tgd1975/automatic_christmas_bell/weihnachtsglocke_Schaltplan.png

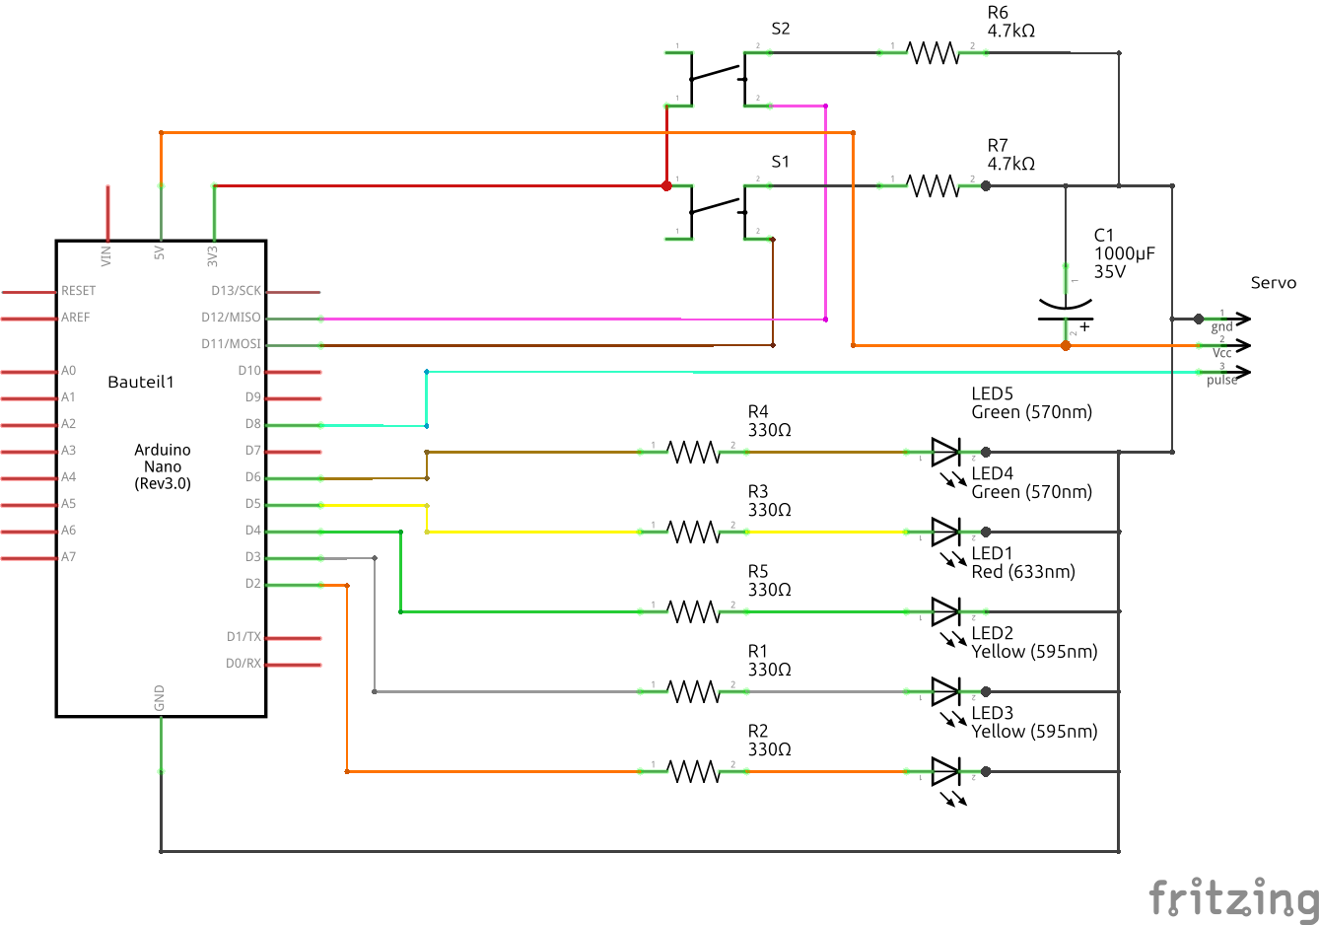
weihnachtsglocke_Schaltplan.png
