tgd1975/automatic_christmas_bell/TODO.md

# Todos

Was nur du selbst tun kannst: Konto, Zahlung, Freigabe, Hardware in der Hand. Was ein Chat selbst kann, gehört nicht
hierher. Form (Stilvorlage dieser Datei):

- offen: `- [ ] TD-<n> - **Was:** Befehl oder Link – warum. *(Chat)*`
- erledigt: `- [x] TD-<n> - **Was:** was daraus wurde (Commit). [2026-11-01]` – ein verworfenes sagt es

Jeder Punkt hat Kästchen und Kennung, offen wie erledigt. Die Kennung gilt nur in dieser Datei, wird hochgezählt und nie
wieder vergeben, auch für erledigte nicht; wer eine Zeile einträgt, nimmt die nächste und zählt sie hier hoch. Vor
jeder Änderung die Datei frisch lesen und nur eigene Zeilen ändern (außer Kennung und Form). Erledigt: sofort abhaken,
Datum ans Ende, nach „## Erledigt“ am Ende verschieben, neueste zuerst – der Chat, der es erfährt, nicht nur der, der
die Zeile schrieb. Keine Zeile wird gelöscht. Überschriften gruppieren offene Todos; ist unter einer keines mehr offen,
gehen Überschrift und Text, bis das nächste dazukommt.

Nächste Kennung: TD-9

## Für dich

- [ ] TD-8 - **THT-Platinen aufbauen** (tht und esp32tht, geliefert 2026-11-11): Schritt für Schritt nach
  [docs/aufbau.md](docs/aufbau.md), zum Drucken `build/aufbau/aufbau.pdf`; die Messwerte aus Schritt 8 (Messen) in den
  Chat. Warum: erst dann gehen TD-1 und TD-2 auf der Platine, und eine laufende Platine kommt mit
  `edakit release publish --built` in die Freigabe. *(automatic-christmas-bell, 2026-11-11)*
- [ ] TD-1 - **ESP32-Firmware auf einem T-Display ausprobieren:**
  `cd variants/esp32/firmware && pio run -e tdisplay -t upload`, dann Hotspot `Glocke-XXXX` (WLAN-Analyse-App: Kanal
  1–13, WPA2), Einrichtung, <http://glocke.local> und Display prüfen, Aufdruck „T-DISPLAY V1.1“ ansehen; Tasten, LEDs
  und Servo erst auf der Platine. Warum: bisher nur übersetzt und am Rechner getestet. *(automatic-christmas-bell-41)*
- [ ] TD-2 - **Nano-Firmware ausprobieren:** `pio run -e nano -t upload` im Repo; nach dem Läuten fährt das Servo in
  die Ruhestellung und ist 1 s später abgeschaltet. Warum: bisher nur übersetzt. *(automatic-christmas-bell-41)*

## Erledigt

- [x] TD-4 - **Platinen bestellt:** die zwei THT-Varianten (tht, esp32tht) unbestückt, je 5 Stück, mit pytrees Baum in
  einer JLCPCB-Bestellung; Teile bei LCSC, mit ihr zusammengelegt (dazu 2 gekerbte 1×40-Buchsenleisten C2916940 als
  Extra), DHL Express. Die Glocken-Platinen gingen ohne Prüfprotokoll in den Warenkorb – edakit konnte unbestückte
  JLCPCB-Platinen erst ab 0.4.17. Hauptplatine, smd und esp32 nicht bestellt. [2026-11-02]
- [x] TD-7 - **edakit-Plugin auf 0.4.14 gehoben:** user- und Projekt-Eintrag 0.4.14, Bridge-Erweiterung 1.6.0 =
  Server 1.6.0 (edakit doctor); der Klon über SSH ging nicht (kein GitHub-Schlüssel) – git leitet
  `git@github.com:tgd1975/` jetzt auf HTTPS um. [2026-11-01]
- [x] TD-6 - **Vier Warnungen DOCS.derived akzeptiert** (R-1, R-3, R-4, R-12, Grund D-39) auf main, smd und esp32 –
  alle drei RELEASED (D-41, 1fa3ba8). [2026-11-01]
- [x] TD-5 - **Blanke Stellen im GND-Kupfer schließen:** ja – main, smd und esp32 mit Stitching-Vias gefüllt, M-5 neu
  (D-41, 67f0b44). [2026-11-01]
- [x] TD-3 - **T-Display vermessen, bevor die ESP32-Platine bestellt wird:** verworfen – D-37: CE-Zeichen vorhanden,
  kein Vermessen; das Footprint bleibt bei LILYGOs Zeichnungen (D-13) (bdc3678). [2026-11-01]
