tgd1975/automatic_christmas_bell/(list of files, drawings)

Other design files:
docs/old/weihnachtsglocke.fzz
weihnachtsglocke.fzz
