tgd1975/automatic_christmas_bell/(commit log)

2026-10-25 Add xmas-bell project files: Arduino sketch and Fritzing schematic
    Generated by Mistral Vibe.
    [weihnachtsglocke.fzz]
2026-10-25 Add comprehensive project documentation
    - Hardware component analysis from Fritzing schematic
    - Software architecture documentation
    - Functional description of countdown and bell mechanism
    - Pin mappings and configuration options
    - Troubleshooting guide and extension ideas
    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
2026-10-25 Add .gitignore for Arduino and Fritzing files
    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
2026-10-25 Update project description with Christkind tradition context
    - Added traditional Austrian/German Christmas context
    - Emphasized mechanical bell vs electronic sound
    - Added detailed use case description
    - Included mechanical assembly suggestions
    - Added tips for staging the Christmas surprise
    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
2026-10-25 Update docs: servo arm hangs down, bell below, intended position in bookshelf
    - README.md: added position details
    - PROJEKT.md: added mechanical arrangement section
    - Intended position: bookshelf with downward-hanging servo arm
    - Bell hangs below, children focused on tree anyway
    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
2026-10-25 Platine mit edakit: Graph, Teile-DB, Simulation, Abzeichnungen
    Hardware-Graph aus weihnachtsglocke.fzz (17 Bauteile, 15 Netze), Teile-DB
    mit LCSC-Nummern, Simulation mit USB-Versorgung, Servo-Last und Tastern,
    Platinenplan 85 x 56 mm für JLCPCB, Entscheidungen E-1 bis E-6.
    edakit check: 0 Fehler; edakit sim: 1112 Prüfungen bestanden.
2026-10-25 Board files in English for the edakit example; EasyEDA project christmas-bell
    The board is the public example of easyEDAAutomation, so graph, parts
    entries, simulation, sign-offs and decisions (docs/decisions.md, D-1..D-6)
    are in English. Buttons switch 5 V instead of 3.3 V (D-4).
2026-10-25 Restructure project: move files to src/firmware/ and docs/old/
    - src/firmware/buttons.ino (was: buttons.ino)
    - docs/old/weihnachtsglocke.* (was: weihnachtsglocke.*)
    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
    [weihnachtsglocke.fzz]
2026-10-25 Board through the gate: fixed resistor positions, LEDs with + on one side, D-7 open
    Generated in EasyEDA project christmas-bell: schematic = graph, PCB routed
    (3 vias, DRC 0), silkscreen clean. Gate: all stages pass except L-9 – the
    Nano footprint's 0.9 mm holes are too small for 0.64 mm header tails (D-7).
2026-10-25 hardware/README.md: the board as edakit example, with plan, routing and silkscreen images
2026-10-25 Apply code review improvements to buttons.ino
    Critical fixes:
    - Fix digitalWrite(-1) by initializing currentledpin to ledRed
    - Add button debouncing (50ms delay) to prevent false triggers
    - Replace blocking delay(10) with non-blocking timer in finishCycle()
    Structural improvements:
    - Introduce explicit state machine with SystemState enum
    - Add timeExpired() helper for safe millis() overflow handling
    - Refactor countdownVisualization to use LED array/loop
    - Replace magic numbers with SERVO_MIN/MAX/REST_ANGLE constants
    - Reduce baud rate from 500000 to 115200 for better compatibility
    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
    [buttons.ino]
2026-10-25 Add build system files: platformio.ini, Makefile, and update README
    - platformio.ini: Configuration for Arduino Uno/Nano with avr platform
    - Makefile: Compile/upload/monitor targets for arduino-cli
    - README.md: Added detailed flashing instructions for all 3 methods
    (Arduino IDE, PlatformIO, Arduino CLI) + troubleshooting table
    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
2026-10-25 Add silkscreen image to README.md
    - Updated README.md to include hardware/img/silkscreen_top.png
    - Added Bestückungsplan section with image reference
    - Updated project structure tree in README
    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
2026-10-25 Board revision 1.0, printed bottom left with the title
2026-10-25 Base load for power banks (D-8), silkscreen artwork and labels
    - R8 ∥ R9 (2 x 100 Ω 2512) keep USB power banks on: 123-135 mA idle,
    checked against a 100 mA minimum in every scenario; graph v0.2
    - hardware/art/make_art.py draws bell, greeting, small bell, chevrons,
    stars and snowflakes; edakit.toml places them, plus START/RESET and the
    servo pin labels (positions follow the current layout, preview only)
2026-10-25 Firmware: builds again, buttons debounce, bell pauses at the end points
    From the M-1 review and a check against the original sketch:
    - bellactive was no longer declared; cyclestarttime and
    nextbellupdatetime are unsigned long (millis arithmetic)
    - debouncing compared the raw reading with the debounced state, so a
    change was never accepted and both buttons were dead; now the raw
    reading of the previous loop is kept (Arduino Debounce example)
    - the bell used timeExpired() with nextbellupdatetime += 400 ms: a time
    in the future counted as expired at once, the 400 ms pause at the end
    points was lost; back to the original next-update logic, overflow-safe
    - currentledpin starts at -1 aga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
    [buttons.ino]
2026-10-25 Board label in German; D-9 LED row stays, D-10 no power switch
2026-10-25 Layout round: base load placed, silkscreen artwork and labels, German board label
    Gate 20261025-211616: every stage passes except L-9 (D-7); DRC 0, 2 vias.
2026-10-25 Silkscreen with printed capital heights; pour clear of the mounting holes
2026-10-25 M-5 signed (gate run 20261025-213920): printed capitals >= 1.0 mm, pour clear of the holes
2026-10-25 D-7: Nano footprint with 1.1 mm holes; gate without findings
    U1 uses the footprint of C9900187880 (1.1 mm holes, same pad numbering,
    turned by 270° in the plan); its symbol labels pins 14/15 swapped (PB4/PB3)
    - documented, connections by pin number. Text fixes and datasheet entries
    of J1 and C1 from the M-1 review. Gate 20261025-215346: no check fails,
    M-1 and M-5 open for the new state.
2026-10-25 M-1 and M-5 signed for the Nano footprint swap (D-7)
2026-10-26 Board variants SMD, THT, ESP32: graphs, parts, simulation, drawn schematics
    Three variants of the carrier board, each its own edakit project under
    variants/ and its own board in the EasyEDA project christmas-bell
    (D-11 to D-15). Offline: 0 errors, every design hint handled, every
    simulation scenario passes. The T-Display device script creates the
    module's symbol and footprint in the EasyEDA project library.
2026-10-26 Variants through EasyEDA: boards, schematics, PCBs routed, silkscreen
    Boards smd, tht and esp32 in the EasyEDA project christmas-bell; template
    and board schematics equal to the graphs, PCBs placed from the plans,
    routed with Freerouting (DRC clean apart from EasyEDA's "Import Changes"
    note), silkscreen without print on pads. The T-Display device is a
    stand-in (C18722937) whose project copies of symbol and footprint are
    rebuilt (D-13); keep-outs around the Nano's corner holes.
2026-10-26 hardware/README.md: link to the board variants
2026-10-26 M-1 signed for the variants smd, tht and esp32
    Independent electrical reviews (agent electrical-reviewer) of the three
    circuits, OK without critical or important findings. esp32: stale texts
    in the C17408 entry and the R8/R9 notes corrected, M-1 confirmed for the
    new state; D-13 and variants/README.md carry the review notes (USB-C CC,
    module orientation, firmware requirements, hand soldering).
2026-10-26 Variants: layout round after the M-5 reviews
    esp32: anode links R->LED as fixed top tracks (no vias in the LED row,
    LED4's label above its LED again), U1 footprint texts 1.5 mm and the USB
    box inside the board, "5V" mark at U1.1, order-number placeholder under
    the module. smd/esp32: keep-outs under the chevrons. tht: 12 mil
    clearance for hand soldering, tracks preferably on the bottom. smd/tht:
    order-number placeholder under the Nano.
2026-10-26 M-5 signed for the variants smd, tht and esp32
    Independent layout reviews (agent pcb-reviewer) on the manufacturing
    files of gate runs 20261026-123018/-123036/-123051: OK for all three
    layouts. variants/README.md: status per variant and what is left – the
    one "Import Changes" click per PCB, then gate runs with the other tabs
    closed and a comparison of the Gerber files with the reviewed runs.
2026-10-26 edakit: board, schematic and pin locks in files of their own
    edakit (148d525) reads edakit.toml as the table of contents now. Moved once with
    edakit's scripts/split_config.py, for the main board and the variants smd, tht
    and esp32:
    - hardware/boards/<board>.toml: outline, holes, tooling holes, placement,
    routing, pours, silkscreen and artwork – word for word, comments included;
    the layout hash covers this file now instead of edakit.toml.
    - hardware/schematic.toml: blocks, notes and pin table of the schematic.
    - [checks] pin_locks into the graph as "checks" – part of the circuit hash.
    Every value read back unchanged; on a copy, edakit check, hints and pcb plan
    gave the same output wi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
2026-10-26 variants/README.md: status after the config split – M-6 open
    The offline gate with edakit 148d525 counts M-1 and M-5 of all three variants
    and leaves M-6 (regulatory review) open next to L-3. M-6 needs the owner's
    purpose decision first.
2026-10-26 Purpose private for all four boards (D-16), radio data of the T-Display
    The owner's purpose decision for the regulatory review M-6: main, smd, tht and esp32
    are built for the owner's own use. The purpose is part of the circuit hash, so M-1
    has to be confirmed again on all four boards. The T-Display's parts entry gets the
    ESP32's radio data from its datasheet v5.3; LILYGO publishes no EU declaration of
    conformity for the module.
2026-10-26 ESP32: radio sources of the T-Display corrected, radio stays off in the firmware
    From the M-6 review: LILYGO publishes a test lab's CE attestation (not an EU
    declaration of conformity), an FCC grant and a Japanese MIC certificate for the
    T-Display V1.1; the MIC certificate gives the antenna gain (-4.32 dBi) and Wi-Fi
    channel 14. The parts entry now cites them. D-13 gets the firmware requirement
    that Wi-Fi and Bluetooth stay off, and the purpose notes and the README say: USB
    power only, no cell at the module's battery input.
2026-10-26 M-1 confirmed and M-6 signed on all four boards (purpose private, D-16)
    M-1: the change adds only the purpose and, on esp32, the T-Display's compliance
    data – checks, simulation and hints unchanged (agent electrical-reviewer).
    M-6 (agent regulatory-reviewer): main, smd and tht OK – no transmitter, 5 V USB,
    no battery, no mains; esp32 OK after one round – the firmware keeps Wi-Fi and
    Bluetooth off (D-13), USB power without a cell. Offline gates count M-1, M-5 and
    M-6 on all four; the variants still need L-3 (Import Changes in EasyEDA).
2026-10-26 Nano firmware: the servo is detached at rest
    From the M-6 note (D-16), with the owner's OK: after the bell phase, and when a
    button interrupts it, the servo moves to its rest position and is detached one
    second later; it is attached again when the next bell phase starts. A jam at rest
    no longer loads the Nano's 5V until the bell is unplugged (D-3). Built with
    PlatformIO (env nano).
    [buttons.ino]
2026-10-26 ESP32 firmware: countdown, display and a web page with a setup hotspot (D-17)
    The owner's wish: a simple web page on the ESP32 board – status, time to ding,
    start, stop, pause, set the timer – and a hotspot on the first start to set the
    home network. variants/esp32/firmware is a PlatformIO project:
    - lib/BellTimer: the countdown without hardware (timer = time to ding, pause,
    LED pattern), 12 host tests (pio test -e native);
    - src/main.cpp: buttons, LEDs, servo on LEDC (detached at rest), display;
    reset held 3 s = Wi-Fi on/off, 10 s = forget the home network;
    - src/net.cpp: setup hotspot with captive portal (WPA2, password made once and
    shown on the display), station in the home net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
    [main.cpp, net.cpp, net.h]
2026-10-26 ESP32: M-1 and M-6 renewed for Wi-Fi (D-17)
    M-1 (agent electrical-reviewer): with i_core_a 0.27 A the module's 1N5819 carries
    0.28 W in the bell phase and 0.48 W stalled for at most 5.8 s (rating 550 mW), the
    AP2112K stays within 600 mA, a USB source of at least 1 A is right; the firmware
    keeps the requirements of D-13. M-6 (agent regulatory-reviewer): station and setup
    hotspot only on channels 1-13 (country DE, 802.11d off), about 16 dBm e.i.r.p.,
    no Bluetooth. Offline gate 20261026-172213 counts M-1, M-5 and M-6. The README
    says to erase the module's flash before it leaves the house and to use an analog
    servo; M-4 checks the hotspot and the module's marking.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
2026-10-26 D-18: the reviewers' suggestions filed as edakit proposals #21-#27
    With the owner's OK: radio power and antenna gain (#21), bands within the EU or
    the radio use stated (#22), modules and microcontrollers state their radio (#23),
    EMVG § 6 and REACH Art. 33 for own use and gifts (#24), a lower bound of a
    module's current (#25), dissipation of a module's on-board LDO (#26), ESP32
    country with 802.11d off (#27). Sealed with edakit proposal seal.
2026-10-28 variants/README.md: status with edakit a8b6011 – hashes kept, P-5 open
    The offline gates with edakit a8b6011 (runs 20261028-085249) keep every hash and
    count M-1, M-5 and M-6. New is warning P-5 on the Nano boards: the Nano is bought
    separately and its parts entry names no supplier. It waits for the owner: shop
    and order code, or the warning accepted with the Nanos at hand (TODO.md).
2026-10-28 D-19: the Nanos are at hand – P-5 accepted; M-5 lapsed with edakit f6dd9f7
    Owner's decision: edakit's warning P-5 (supplier per part, since a8b6011) is
    accepted for U1 (C9900187880) on main, smd and tht – the Nanos are at hand. The
    acceptance names the part, so it lapses when U1 changes.
    edakit f6dd9f7 puts the artwork SVGs into the layout hash, so all four layout
    hashes are new and M-5 no longer counts. The SVGs are unchanged since 7667817,
    older than every M-5 review: the owner confirms M-5 for the new hashes after the
    EasyEDA gates (TODO.md), whose pcb dump may change the footprint geometry too.
2026-10-28 D-20: M-5 bound to the manufacturing files of the reviewed runs (scope fab)
    Since edakit f6dd9f7 the artwork SVGs count in the layout hash, so M-5 lapsed on all four
    boards although the boards did not change. M-5 now has edakit's default scope fab and is
    bound to the fab hash of the gate run its reviewer checked; the EasyEDA gate counts it when
    it exports the same files. No confirmation by the owner is needed.
2026-10-28 Footprint geometry beside the board files, versioned (edakit step 1.8)
    edakit d63a81a reads the geometry from hardware/boards/<b>.geometry.json, so CI and a fresh
    clone can compute the layout hash, and make clean no longer deletes it. The four files were
    moved from build/edakit/ as edakit check suggested. The layout hashes change once (main
    037fdb66, smd cebf13a6, tht 4c4bf230, esp32 7f428bbc). Circuit and fab hashes stay the same,
    so M-1, M-5 (scope fab, D-20) and M-6 keep counting.
2026-10-28 make clean: delete only .pio – build/ holds edakit's gate runs
    Neither arduino-cli nor PlatformIO builds into build/; there lie edakit's artifacts, among them
    the reviewed and the released gate runs of the main board.
2026-10-28 Regulatory review: support, not legal advice (owner's instruction)
    The owner asked that wherever regulatory matters come up it says so: no legal advice, no
    claim to correctness, nothing legally guaranteed. Added to D-16, the radio bullet of D-13,
    both READMEs and the M-6 text of the four sign-off files, which the gate protocol prints.
    The sign-off files are in no hash, so M-6 keeps counting.
2026-10-29 D-18: edakit accepted all seven proposals (main bf7450a) – G-24, G-25, P-11, two features
    For a private board G-25 and P-11 are notes (owner's rule: edakit reports what the firmware has to keep but does
    not block on it), so the gate decisions stay. The entries that clear the notes and the keys of #25/#26 change the
    circuit hash; they come with each board's next circuit change.
2026-10-31 Release of all four boards (2026-10-30): gates with EasyEDA RELEASED, D-21
    After Import Changes on smd, tht and esp32, the gates of edakit b36a6d0 failed only L-17 (the silk files of an
    older silk apply). silk apply ran again; the manufacturing files are the reviewed runs' (D-20), so M-5 counts.
    The footprints' own print and main's copper-free spot are accepted warnings (D-21, owner).
    The runs were made on 8a25612 plus this commit's sign-off changes. Runs: main 20261030-232729 (supersedes
    20261025-220549), smd 20261030-232631, tht 20261030-232650, esp32 20261030-232707 – they stay in build/.
2026-10-31 Manufacturing files are build output: not archived, published with the order (make publish, D-22)
    The owner rejected the archived gate runs (build artifacts, not repository content). What holds a release is
    the sign-offs' hashes; the gate re-exports identical files while the PCB is untouched, and JLCPCB keeps ordered
    files.
    make publish (tools/publish_release.py): edakit release current per board, edakit release verify on the order
    files, build/publish/<tag>/ with SHA256SUMS and notes, gh release create --prerelease, tag = the date. Guards:
    clean tree, HEAD on origin/main. make publish-draft tests it as a draft (done today: 21 files, deleted again);
    make publish-built TAG=<tag> drops the pr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
2026-10-31 D-22: the owner wants no-archive and publish as edakit's default – handed to edakit as a prompt
2026-10-31 Variant ESP32 THT: the T-Display board with through-hole parts, no assembly (D-23)
    Graph, parts, simulation and drawn schematic of a fifth board esp32tht:
    the circuit of the variant ESP32 with the THT parts of the variant THT,
    100 ohm THT series resistors (C57438) and 5 mm yellow-green LEDs
    (XL-504SYGD, C2895551). purpose.radio states channels 1-13. In the
    form of edakit main 5196c6f; check 0 errors, sim 1436 passes.
2026-10-31 ESP32 THT: red and yellow dimmed to the yellow-green (330 ohm), order and layout hand-over (D-23)
    Owner's decision after M-1: R1, R2, R5 330 ohm (C58608) so that the
    50-200 mcd yellow-green LEDs and the 400-900 mcd red and yellow ones look
    alike. From the M-1 review: U1 names its supplier (the stand-in left the
    LCSC cart), the two 1x12 female headers as [[extra]], the layout
    hand-over in the graph, U1's least current and LDO thermal data, LED
    colour from edakit's list, R8/R9 notes. M-6 signed for e4a24024 (now
    superseded, renewal follows). Board file and seed geometry for the
    layout; variants/README.md with the fifth board.
2026-10-31 ESP32 THT: the servo header at its place of every board, not at the edge
2026-10-31 ESP32 THT: layout round – placed, routed (0 vias), silkscreen
    The T-Display 3.5 mm nearer the front than on esp32 so that tht's
    staggered THT resistors fit; R8/R9 standing between the module and C1,
    their names inside their bodies. Geometry from pcb dump (its hole sizes
    are 10x too small – edakit bug, reported; dump again after the fix).
2026-10-31 ESP32 THT: M-1 and M-6 signed for state bcb27b87 (agents, D-23)
2026-10-31 ESP32 THT: layout notes of M-5 – LED marks, label off the edge, two tracks to the bottom, looks guard
2026-10-31 ESP32 THT: geometry dumped again with the hole unit fixed, LED_G1 fixed on the bottom – 0 vias
    The dump ran with edakit's fix/dump-hole-unit (c831353: main 6c3cb90 plus the one fix), the holes are now the
    footprints' (1.1 mm sockets, 0.91 mm LEDs). Routing with the M-5 notes left one via on LED_G1, which changed to the
    top for its last 6 mm; its route is now a fixed wire on the bottom. Routed: 16 nets, 0 vias, top 0.27 m, DRC 0;
    silkscreen 19/19 designators, 0 on mask openings.
2026-10-31 ESP32 THT: M-5 signed on gate run 20261031-154618, the buttons' print accepted as D-21 (1)
    M-5 by the agent pcb-reviewer on fab hash b768d2f5… – no block or important finding; notes: S1/S2's 1.3 mm holes do
    not hold the snap-in legs (press them flat while soldering), a stale via drill file in the working export (deleted,
    not part of the run). Owner's decision 2026-10-31: D-21 (1) holds for esp32tht too – accepted, bound to S1/S2 =
    C110153. Recorded in D-23.
2026-10-31 ESP32 THT: released – gate run 20261031-160323, status and order note in variants/README.md
    The second gate run on the same manufacturing files (fab b768d2f5…) is RELEASED with M-1, M-5 and M-6 signed and the
    buttons' print accepted (D-21 (1)). `edakit release verify` accepts the current release of all five boards, so
    `make publish` takes esp32tht along. esp32tht has no order-number placeholder – noted for the order.
2026-10-31 All boards in edakit's current file form – edakit convert on main, smd, tht and esp32 (D-24)
    edakit 8bdb933 no longer reads the form before its restructuring. Graph, parts entries and sign-off files converted;
    M-1/M-6 rehashed, releases unchanged, check/sim/docs pass on all five boards.
2026-10-31 Decisions D-25 to D-29: the bell on edakit 868e942 – migrate first, LIM.p on esp32 accepted, order form keys, wires, publish with edakit
2026-10-31 Graph as TOML on all five boards (edakit graph convert, L.9) – graph.json is the generated file now
    edakit graph json against the former graph.json: only conventions.pin_reference differs (and key order).
    M-1/M-6 rehashed, releases unchanged. The mentions of graph.json name the generated file (hardware/README.md,
    docs/decisions.md, the esp32 firmware's comment, also its stale checks.pin_locks → locks.pins).
2026-10-31 Guard rails: pre-commit hook with edakit check/sim/graph json --check per board, project settings with the plugin; esp32 LIM.p accepted (D-26)
    tools/edakit finds edakit ($EDAKIT, PATH, the installed plugin) for the hook and the Makefile.
    core.hooksPath = .githooks (once per clone).
2026-10-31 Scripts registered (plan 4.2): kunst in all five configurations, tdisplay (symbol) in esp32 – both stamped, the art unchanged; make publish runs edakit release publish (D-29)
    tools/publish_release.py goes; [release] archive = "none" and publish = { variants, decisions } in the main
    configuration.
2026-10-31 T-Display's footprint as data on esp32 and esp32tht (D-30, plan 3.6) – the symbol stays tdisplay_device.py's
2026-10-31 Nano pin print from edakit's A000005 in main, smd, tht (D-31, W.5)
2026-10-31 D-27 changed: no order number on any board – the placeholder leaves smd, tht and esp32
    JLCPCB's form no longer offers an order number (edakit-c9, ordering step 0, 2026-10-31). Owner's decision: mark
    "remove" on all five boards and nothing instead. The JLCJLCJLCJLC silk text comes off the three board files; the
    ordering note in variants/README.md says "Remove Mark". EasyEDA and the gate follow in the D-25 round.
2026-10-31 Requirements file (plan 4.1, D-32): shared, Nano and ESP32 files, all accepted; IMPLEMENTIERUNG.md to docs/old/, README and AGENTS to the built state
2026-10-31 Servo start as transient run for R-9 (D-33); the circuit items waiting since D-18/D-23 (D-34); hook: its own variable, so that EDAKIT from the environment reaches tools/edakit
2026-10-31 Schematic drawings with wires on all five boards (D-28), main's drawn for the first time
2026-10-31 Order form, cost, sockets, firmware contract and quoted values as keys (steps 8 and 9, D-35)
2026-10-31 Stock snapshots of all five boards (edakit stock, 2026-11-01)
2026-10-31 D-36: the ESP32 boards' radio in Austria – the CE-marked module is the radio equipment (owner, M-6 finding E1)
2026-10-31 M-1 and M-6 signed anew on all five boards (agents electrical-reviewer, regulatory-reviewer; edakit bc44fa7) – M-6 on the electrical hash, D-36 for the ESP32 radio
2026-10-31 esp32, esp32tht: geometry dumped again – U1's pads with shape, size and hole for SYNC.footprint (passes)
2026-10-31 M-5 signed on the gate runs of 2026-11-01 (agent pcb-reviewer): placeholder off, order.json new, nothing else changed
2026-10-31 All five boards released on edakit bc44fa7 (runs 20261101-0055..0058) – status in variants/README.md
2026-11-01 D-37: the T-Display bears the CE mark and has the standard row spacing – no measuring; its open item and print wait for the next circuit change
2026-11-01 docs: why the bell's requirements restate edakit's checks, and proposals A–F for edakit (requirements-review.md, gap 10)
2026-11-01 docs: edakit-gaps 10 – the count as in requirements-review.md
2026-11-01 docs: requirements are the pipeline's inputs (owner, 2026-11-01) – requirements-review.md and gap 10 rewritten: 17 of 20 derived, the README's inputs missing, proposals A–G
2026-11-01 docs: requirements-review.md – proposal C in two cases: forward (the maker states) and reverse (infer from the circuit, filter, marked as inferred, owner confirms)
2026-11-01 docs: requirements-review.md – C compact, F as today plus a source word (owner: don't overengineer the process)
2026-11-01 docs: requirements-proposal.toml – the bell's requirements as the pipeline's inputs, for review (not read by edakit; parsed by edakit req in a throwaway project: 9 needs, 13 requirements)
2026-11-01 D-38: the requirements proposal reviewed by the owner – level fits, LED order and jam confirmed, one requirement per assembly (SMD, THT) for both modules
2026-11-01 D-39: the requirements proposal accepted as a whole; it replaces D-32's files after the order; proposals A–G to edakit
2026-11-01 docs/organisation.md: what each part of the repository is, who keeps it, how it changes, and what a review of the documentation may change – as edakit's docs/organisation.md; AGENTS.md and the README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
2026-11-01 D-39: edakit #98 accepted – DOCS.derived built in #96
2026-11-01 TODO.md: was nur der Besitzer tun kann, aus der projektübergreifenden Liste ~/Dokumente/Projekte/TODO.md hierher (die gibt es nicht mehr); die drei Bestellzeilen zu einer mit dem Skill cart, das Plug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
2026-11-01 TODO.md: measuring the T-Display ticked – dropped by the owner in D-37
2026-11-01 docs/organisation.md: TODO.md as a source in the repository – the owner's to-do list outside it goes (c7c28aa)
2026-11-01 D-40: board views from the released Gerber files – edakit main draws most of them, the overlay of all layers proposed to edakit
2026-11-01 D-40: edakit #99 – the board's layers over each other
2026-11-01 TODO.md: every to-do gets an ID TD-<n>, unique in the file and never reused – the header names the next one (owner's rule, now global)
2026-11-01 TODO.md: TD-4 rewritten – only the owner's part (plugin update first, JLCPCB login, M-2, paying); the esp32tht placeholder warning is gone since D-27, the publish commands are a chat's
2026-11-01 D-40: edakit #99 accepted, built in 166b847 (PR #101) – checked on the main run (45 pads, the via tented)
2026-11-01 TODO.md: done to-dos dated and moved to "## Erledigt", none deleted (owner's rule of 2026-11-01) – TD-3 there, dropped in D-37
2026-11-01 TODO.md: the owner's layout – "TD-<n> - **Was:**", closed with what came of it, the commit and the date at the end; the header keeps it as the style guide
2026-11-01 TODO.md: TD-5 – before the order, decide whether to close the bare spots in the GND pour (main, smd, esp32) with stitching vias
2026-11-01 D-41: bare GND islands on main, smd and esp32 to be closed with stitching vias (owner's yes to TD-5); GEO.pour's area gap to edakit
2026-11-01 D-41: GND islands stitched on main, smd and esp32 (stitch in [[pours]], esp32 one entry per side) – DRC 0, M-5 signed anew on the new fab hashes; D-21 (4)'s acceptance gone; TD-5 done, TD-6 for the D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
2026-11-01 D-41: DOCS.derived accepted on main, smd and esp32 (owner, D-39's reason) – all three RELEASED with the fab hashes M-5 reviewed; TD-6 done
2026-11-01 hardware/img: silkscreen and routing pictures from release 20261101-142527 (after D-41)
    The top view and the two copper layers from the released Gerber files, with the GND pours
    and D-41's stitching; the offline previews of route check and silk preview show neither.
    The placement plan is unchanged (pcb plan writes the same picture).
2026-11-01 docs/kostenvergleich.md: prices of all five boards at JLCPCB, Eurocircuits and AISLER (2026-11-01)
    JLCPCB 4.65 € (bare) to 34.58 € (esp32 assembled) for 5 boards; Eurocircuits and
    AISLER 7–18 times as much and unable to price the LCSC-specific parts; PCBWay not
    reachable from Claude in Chrome. Hand-solder parts from LCSC, shipping to Austria,
    edakit cost against the quotes.
2026-11-01 docs/kostenvergleich.md: PCBWay's prices – bare 6.50 USD, assembly 29 USD (promotion) without parts, shipping to Austria
2026-11-01 docs/kostenvergleich.md: JLCPCB's shipping for 0.42 kg (the assembled boards' weight), read with pytree's board
2026-11-01 TODO.md: TD-7 – the edakit plugin to 0.4.13 and EasyEDA's bridge extension 1.6.0
2026-11-01 TODO.md: TD-7 closed – edakit 0.4.14 in user and project scope, bridge extension 1.6.0
2026-11-01 variants tht, esp32tht: [order] customs – DIY, HS code 902300 (the owner, 2026-11-01)
2026-11-02 TODO.md: TD-4 closed – tht and esp32tht ordered bare at JLCPCB with pytree's tree (edakit-04)
2026-11-02 variants tht, esp32tht: the real cost of the first order (edakit cart actual)
    JLCPCB's order page of 2026-11-02: each bare board 5 pcs at $5.20
    (Special Offer 4.00 + Surface Finish 1.20), priced as 85 × 56 mm – the
    project's fee table of each variant, created by this order. No order
    number, as decided.
2026-11-02 Hook: edakit's block (edakit hook install) instead of the own loop; gap 2 closed
    The pre-commit hook is the header and edakit's block, written by `edakit hook install` (edakit 1.0.11): it finds
    edakit itself and runs check, sim, graph json --check, firmware --check and docs for every configuration whose files
    are staged – what the loop did. tools/edakit stays for the Makefile. docs/edakit-gaps.md: gap 2 closed for the hook.
2026-11-11 Docs: build guide for the bare boards tht and esp32tht (docs/aufbau.md)
    Step by step what to solder in which order, polarity of LEDs, C1 and the
    module, measuring before the first power, firmware and test – like
    pytree's docs/aufbau.md. German, like the README; the pictures are the
    board views of the ordered state (rev 1.0).
2026-11-11 docs/aufbau_pdf.py: the build guide as a printable PDF (build/aufbau/aufbau.pdf)
    Markdown to HTML to Chromium headless, as pytree's hardware/aufbau.py;
    page breaks before the parts list, the order, step 7 and step 9. The
    PDF is build output and stays in build/ (D-22).
2026-11-11 docs/aufbau.md: the resistors' colour bands drawn in the table
    docs/aufbau_pdf.py draws them from the value (5 bands, 1 % metal film)
    as docs/img/ringe_{100,330,4k7}.svg; readable on light and dark
    backgrounds. In the PDF the sentence before a table stays with it.
2026-11-11 docs/aufbau.md: step 8 measures every connection, with pictures of the points
    8.1 supply, 8.2 the five LED paths by diode test, 8.3 the buttons,
    8.4 module sockets to J1, 8.5 the voltages with the module – each with
    the expected value and what a wrong one means. docs/aufbau.py (was
    aufbau_pdf.py) draws the pictures over the board views from the boards'
    geometry and checks that every socket it marks is on the net its label
    names. The board views are SVG now (copies of the release views of
    2026-11-01, rev 1.0).
2026-11-11 docs/aufbau.md: assembled boards in the measuring pictures; when the module, USB and servo go in
    The pictures of step 8 show the board as it is then: every part drawn
    from the graph and the geometry – resistors with their bands, LEDs in
    their colour with the flat on the cathode side, C1 with its minus
    stripe, the empty female headers; 8.5 with the module plugged in.
    The order table says per step whether module, USB and servo are in;
    three rules (solder without power, plug only with USB off, the module
    gets power first in 8.5) and a state line at every step.
2026-11-11 TODO.md: TD-8 build the THT boards, delivered 2026-11-11
2026-11-11 docs/aufbau.md: test protocol at the end of step 9, one per board
    Four blocks – after soldering, measuring without the module, with the
    module, firmware and function – each row with step, target value, a
    field for the measured value and a box to tick. In the PDF it starts
    on a page of its own and fills one sheet printed on both sides.
2026-11-11 variants/README.md: ideas for rev 1.1 from building the THT boards
    Net names next to the module sockets, LED1's footprint marked like the
    others, a GND loop, a 3V3 test pad on the ESP32 boards – the owner,
    2026-11-11.
2026-11-11 docs/aufbau.md: step 8 says that 8.1–8.4 measure resistance on an unpowered board
    "5V" and "GND" there are the names of the lines, not voltages; 8.1
    explains why R8 ∥ R9 read 50 Ω. Voltage comes in 8.5 only (the owner's
    question, 2026-11-11).
2026-11-11 docs/aufbau.md: every measuring step opens with its state and what it tests
    8.1–8.5 each start with a state line (module, USB, servo, meter range)
    and one or two sentences on what the step checks (the owner,
    2026-11-11). 8.5's remarks folded into its table, the bottom picture
    into its picture table. PDF: each measuring step on a page of its own;
    picture tables break only between rows.
2026-11-11 docs/aufbau.md: review for hobby makers – terms explained, print's '+' named, countdown as the firmware does it
    - Vorwiderstand, Pull-down, Grundlast, OL and ∥ are explained where they first matter
    - how to read the five rings, and to measure each resistor
    - LEDs: the '+' printed at the left hole; LED1's square pad is that same hole
    - 'senkrecht' no longer reads as mounted upright; legs bent 2 mm beside the body
    - 8.2: wrong LED glowing means the neighbouring socket; OL on all five means the meter
    - 8.3: where the 4.75 kΩ come from
    - step 9: the Nano's LEDs show the remaining time, all five blink for the last 5 s
    - typo 'gelöst', the troubleshooting row for START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
2026-11-11 docs/aufbau.md: a build guide, not a course – explanations and decision references removed
    On the owner's word: the reader understands electronics and only lacks the
    colour codes by heart. Gone are the intro's summary, the notes on cutting the
    female headers, what the resistors are for, how to read colour rings, the
    decision references D-…, and the explanations of OL, ∥ and a cold joint. The
    ring table and the polarity chapter stay.
2026-11-11 docs/aufbau.md: warning in 8.5 – a probe across two J1 pins can cost a module
    5V sits between GND and SIG at 2.54 mm: 5V on SIG puts 5 V on the T-Display's
    3.3 V pin, 5V on GND shorts the supply. aufbau.py prints a blockquote that
    starts with 'Achtung' in red.
2026-11-11 docs/aufbau.md: parts table merges the cells where both boards take the same part
2026-11-11 docs/aufbau: 5 V measured at R9 instead of J1, short warning, PDF with header, footer and its state
    - 8.5 measures 5 V across the legs of R9 (15.5 mm apart, nothing in reach of a
    probe) and takes GND for the 3V3 reading from R9's joint; on J1 the 5V pin
    sits 2.54 mm from SIG and GND. R8 was ruled out: on esp32tht its 5V leg is
    3.5 mm from the START pull-down. aufbau.py checks R9's nets.
    - The warning is two lines, a reminder for a reader who knows the principle.
    - The PDF names the boards' revisions, the commit and its date on the first
    page and in header and footer, with page n of N; a '+' marks a guide that
    is not committed.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
2026-11-11 docs/aufbau.md: parts table without bold – the split cells already show what differs
